dvarkin-ru/eprom_programmer/kicad/programmer.pdf

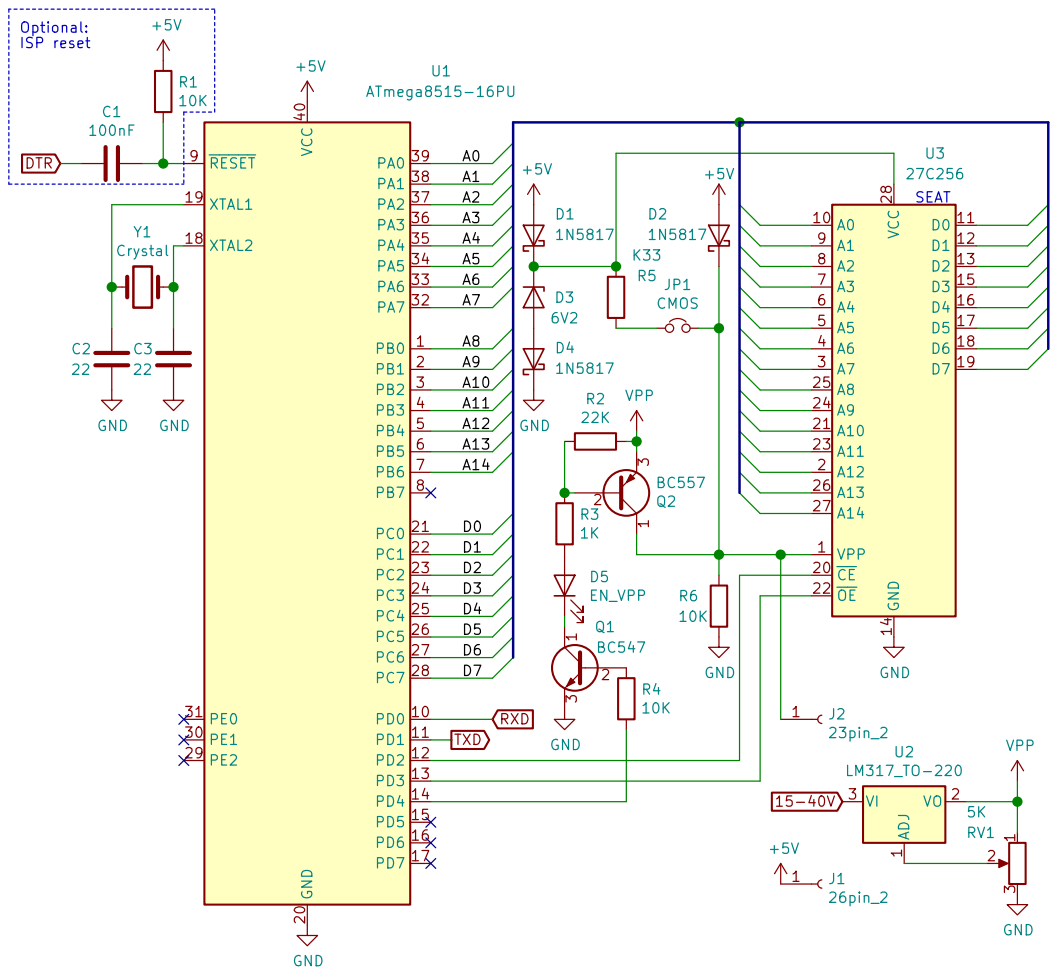
[picture p2: page 1]
