dvarkin-ru/eprom_programmer/kicad/programmer.sch

## KiCad design kicad/programmer.sch (2020-05-29)

Schematic: programmer.sch

Parts:
C1: 100nF
C2, C3: 22
D1, D2, D4: 1N5817; D_DO-41_SOD81_P10.16mm_Horizontal
D3: 6V2; D_DO-41_SOD81_P10.16mm_Horizontal
D5: EN_VPP
J1: 26pin_2
J2: 23pin_2
JP1: CMOS
Q1: BC547; TO-92_Inline
Q2: BC557; TO-92_Inline
R1, R4, R6: 10K
R2: 22K
R3: 1K
R5: K33
RV1: 5K
U1: ATmega8515-16PU; DIP-40_W15.24mm
U2: LM317_TO-220
U3: 27C256; DIP-28_W15.24mm
Y1: Crystal

Notes on the sheet:
Optional: ISP reset
SEAT
