dvarkin-ru/eprom_programmer/(commit log)

2020-01-09 Initial commit.
    [programmer.sch]
2020-01-09 Create README.md
    Short readme with schematic.
2020-01-12 Schematic update D4, R8, ISP reset resistor, "SEAT" and features in README
    [programmer.sch]
2020-05-29 NMOS and 2716 adaptation.
    [programmer.sch]
